jakea712/nixieClock_ZM1000/nixieClock_ZM1000.kicad_pcb

## KiCad design nixieClock_ZM1000.kicad_pcb (2020-04-06)

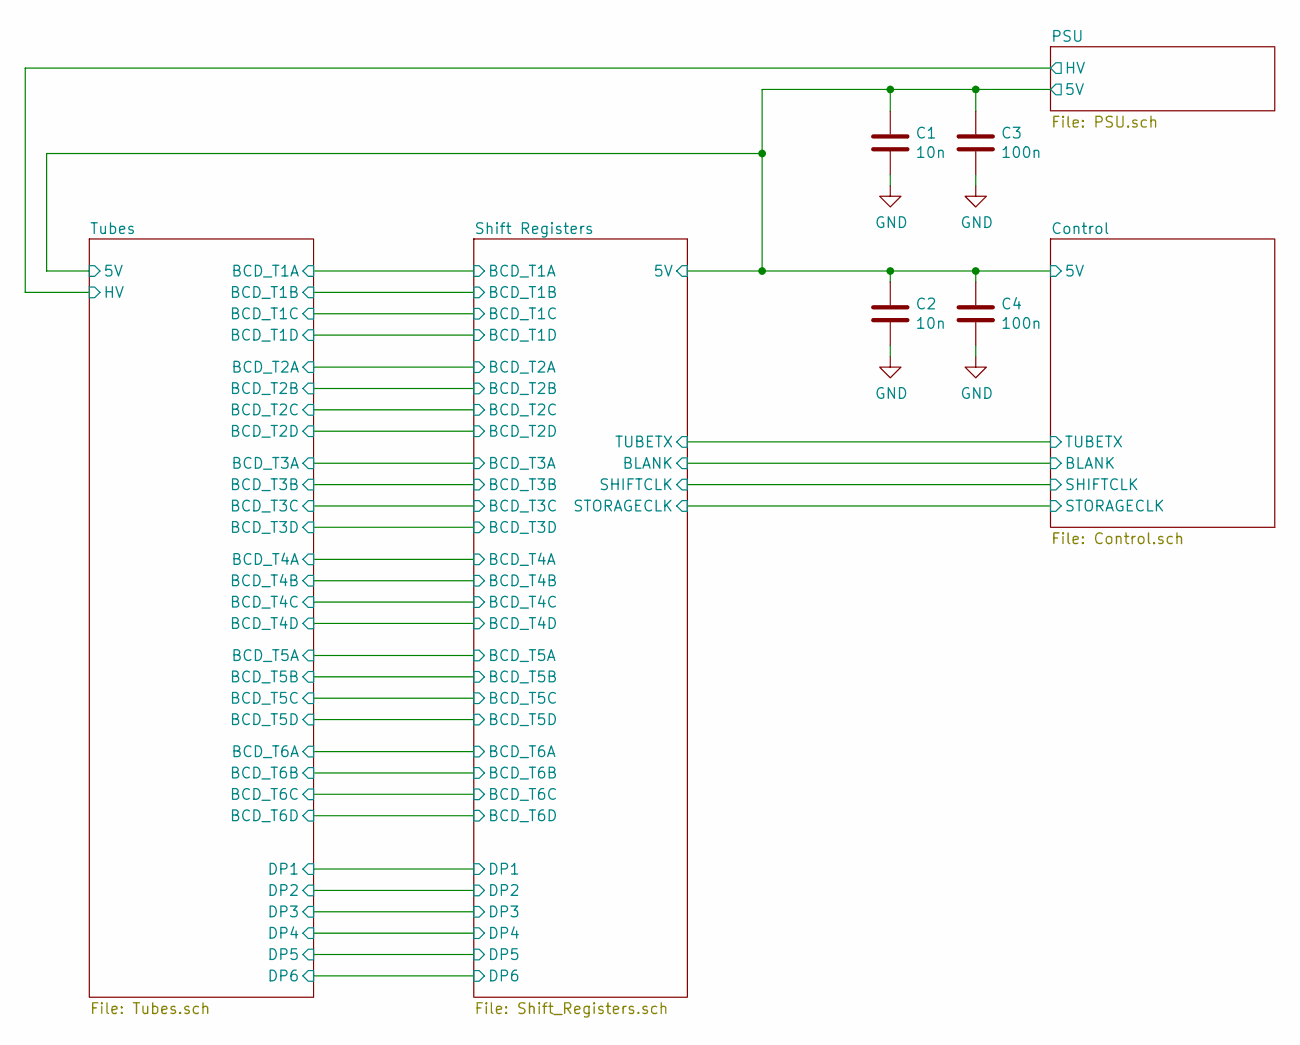
[picture p1: schematic nixieClock_ZM1000.sch]

Parts:
C1, C2: 10n; C_Disc_D3.8mm_W2.6mm_P2.50mm
C3, C4: 100n; C_Disc_D5.0mm_W2.5mm_P2.50mm

Connections:
/Control/5V: C1.1, C2.1, C3.1, C4.1; also elsewhere on the board
GND: C1.2, C2.2, C3.2, C4.2; also elsewhere on the board

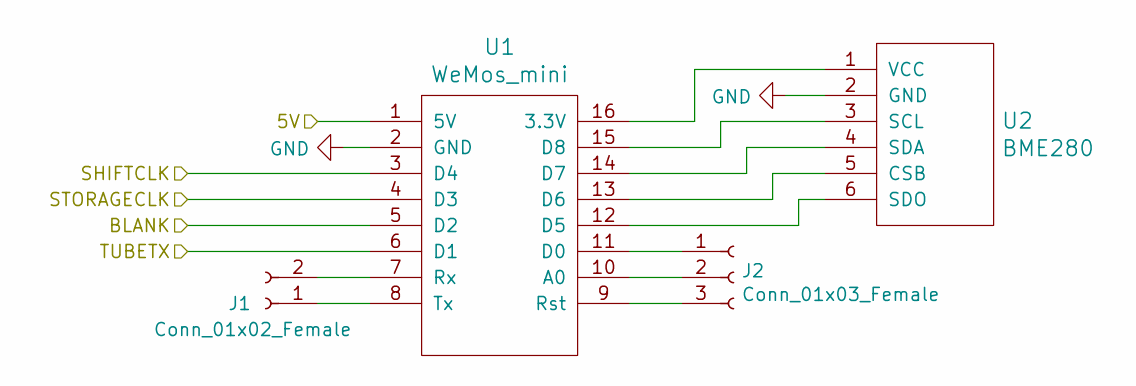
[picture p2: schematic Control.sch]

Parts:
J1: Conn_01x02_Female; PinHeader_1x02_P2.54mm_Vertical
J2: Conn_01x03_Female; PinHeader_1x03_P2.54mm_Vertical
U1: WeMos_mini; D1_mini_board
U2: BME280

Connections:
/Control/5V: U1.1 (5V); also elsewhere on the board
/Control/BLANK: U1.5 (D2); also elsewhere on the board
/Control/SHIFTCLK: U1.3 (D4); also elsewhere on the board
/Control/STORAGECLK: U1.4 (D3); also elsewhere on the board
/Control/TUBETX: U1.6 (D1); also elsewhere on the board
GND: U1.2 (GND), U2.2 (GND); also elsewhere on the board
unnamed: J1.1, U1.8 (Tx)
unnamed: J1.2, U1.7 (Rx)
unnamed: J2.1, U1.11 (D0)
unnamed: J2.2, U1.10 (A0)
unnamed: J2.3, U1.9 (Rst)
unnamed: U1.12 (D5), U2.6 (SDO)
unnamed: U1.13 (D6), U2.5 (CSB)
unnamed: U1.14 (D7), U2.4 (SDA)
unnamed: U1.15 (D8), U2.3 (SCL)
unnamed: U1.16 (3.3V), U2.1 (VCC)

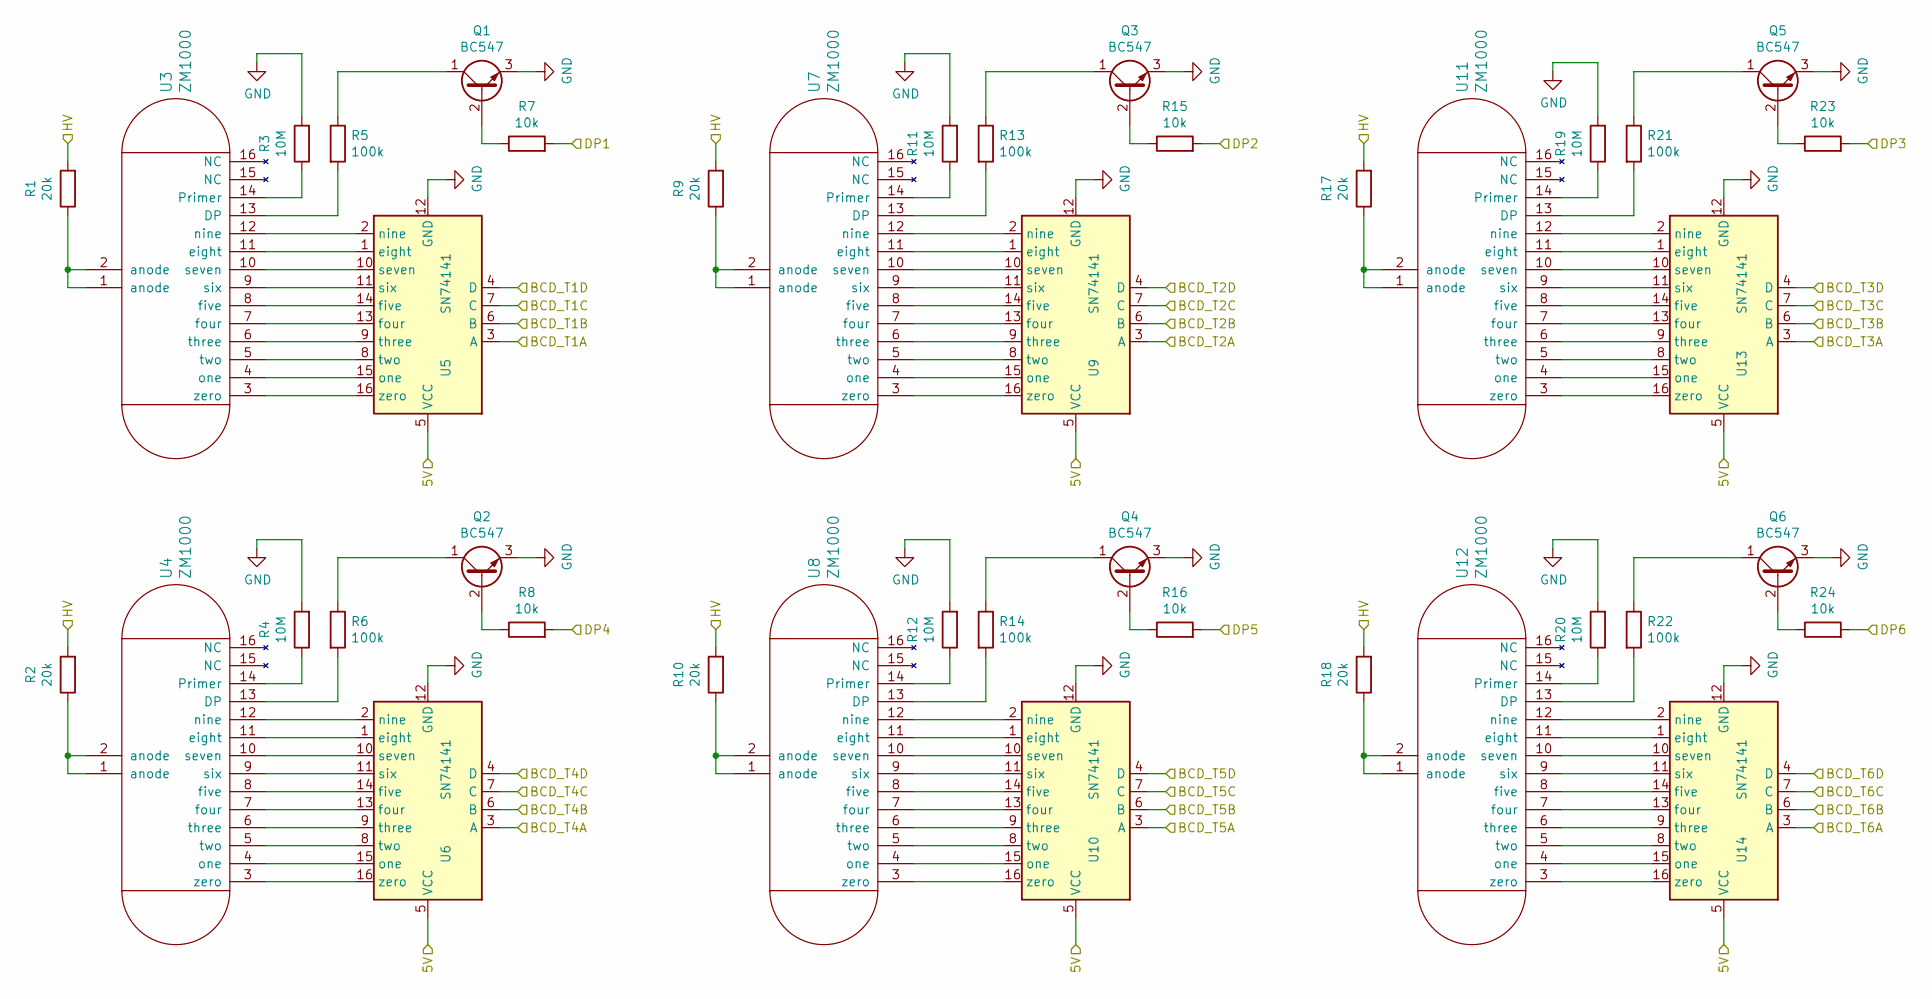
[picture p3: schematic Tubes.sch]

Parts:
Q1, Q2, Q3, Q4, Q5, Q6: BC547; TO-92_Inline
R1, R2, R9, R10, R17, R18: 20k; R_Axial_DIN0207_L6.3mm_D2.5mm_P10.16mm_Horizontal
R3, R4, R11, R12, R19, R20: 10M; R_Axial_DIN0207_L6.3mm_D2.5mm_P10.16mm_Horizontal
R5, R6, R13, R14, R21, R22: 100k; R_Axial_DIN0207_L6.3mm_D2.5mm_P10.16mm_Horizontal
R7, R8, R15, R16, R23, R24: 10k; R_Axial_DIN0207_L6.3mm_D2.5mm_P10.16mm_Horizontal
U3, U4, U7, U8, U11, U12: ZM1000; Nixie_ZM1000
U5, U6, U9, U10, U13, U14: SN74141; DIP-16_W7.62mm

Connections:
/Control/5V: U5.5 (VCC), U6.5 (VCC), U9.5 (VCC), U10.5 (VCC), U13.5 (VCC), U14.5 (VCC); also elsewhere on the board
/PSU/HV: R1.2, R2.2, R9.2, R10.2, R17.2, R18.2; also elsewhere on the board
/Shift Registers/BCD_T1A: U5.3 (A); also elsewhere on the board
/Shift Registers/BCD_T1B: U5.6 (B); also elsewhere on the board
/Shift Registers/BCD_T1C: U5.7 (C); also elsewhere on the board
/Shift Registers/BCD_T1D: U5.4 (D); also elsewhere on the board
/Shift Registers/BCD_T2A: U9.3 (A); also elsewhere on the board
/Shift Registers/BCD_T2B: U9.6 (B); also elsewhere on the board
/Shift Registers/BCD_T2C: U9.7 (C); also elsewhere on the board
/Shift Registers/BCD_T2D: U9.4 (D); also elsewhere on the board
/Shift Registers/BCD_T3A: U13.3 (A); also elsewhere on the board
/Shift Registers/BCD_T3B: U13.6 (B); also elsewhere on the board
/Shift Registers/BCD_T3C: U13.7 (C); also elsewhere on the board
/Shift Registers/BCD_T3D: U13.4 (D); also elsewhere on the board
/Shift Registers/BCD_T4A: U6.3 (A); also elsewhere on the board
/Shift Registers/BCD_T4B: U6.6 (B); also elsewhere on the board
/Shift Registers/BCD_T4C: U6.7 (C); also elsewhere on the board
/Shift Registers/BCD_T4D: U6.4 (D); also elsewhere on the board
/Shift Registers/BCD_T5A: U10.3 (A); also elsewhere on the board
/Shift Registers/BCD_T5B: U10.6 (B); also elsewhere on the board
/Shift Registers/BCD_T5C: U10.7 (C); also elsewhere on the board
/Shift Registers/BCD_T5D: U10.4 (D); also elsewhere on the board
/Shift Registers/BCD_T6A: U14.3 (A); also elsewhere on the board
/Shift Registers/BCD_T6B: U14.6 (B); also elsewhere on the board
/Shift Registers/BCD_T6C: U14.7 (C); also elsewhere on the board
/Shift Registers/BCD_T6D: U14.4 (D); also elsewhere on the board
/Shift Registers/DP1: R7.2; also elsewhere on the board
/Shift Registers/DP2: R15.2; also elsewhere on the board
/Shift Registers/DP3: R23.2; also elsewhere on the board
/Shift Registers/DP4: R8.2; also elsewhere on the board
/Shift Registers/DP5: R16.2; also elsewhere on the board
/Shift Registers/DP6: R24.2; also elsewhere on the board
GND: Q1.3 (E), Q2.3 (E), Q3.3 (E), Q4.3 (E), Q5.3 (E), Q6.3 (E), R3.2, R4.2, R11.2, R12.2, R19.2, R20.2, U5.12 (GND), U6.12 (GND), U9.12 (GND), U10.12 (GND), U13.12 (GND), U14.12 (GND); also elsewhere on the board
unnamed: Q1.1 (C), R5.1
unnamed: Q1.2 (B), R7.1
unnamed: Q2.1 (C), R6.1
unnamed: Q2.2 (B), R8.1
unnamed: Q3.1 (C), R13.1
unnamed: Q3.2 (B), R15.1
unnamed: Q4.1 (C), R14.1
unnamed: Q4.2 (B), R16.1
unnamed: Q5.1 (C), R21.1
unnamed: Q5.2 (B), R23.1
unnamed: Q6.1 (C), R22.1
unnamed: Q6.2 (B), R24.1
unnamed: R1.1, U3.1 (anode), U3.2 (anode)
unnamed: R2.1, U4.1 (anode), U4.2 (anode)
unnamed: R3.1, U3.14 (Primer)
unnamed: R4.1, U4.14 (Primer)
unnamed: R5.2, U3.13 (DP)
unnamed: R6.2, U4.13 (DP)
unnamed: R9.1, U7.1 (anode), U7.2 (anode)
unnamed: R10.1, U8.1 (anode), U8.2 (anode)
unnamed: R11.1, U7.14 (Primer)
unnamed: R12.1, U8.14 (Primer)
unnamed: R13.2, U7.13 (DP)
unnamed: R14.2, U8.13 (DP)
unnamed: R17.1, U11.1 (anode), U11.2 (anode)
unnamed: R18.1, U12.1 (anode), U12.2 (anode)
unnamed: R19.1, U11.14 (Primer)
unnamed: R20.1, U12.14 (Primer)
unnamed: R21.2, U11.13 (DP)
unnamed: R22.2, U12.13 (DP)
unnamed: U3.3 (zero), U5.16 (zero)
unnamed: U3.4 (one), U5.15 (one)
unnamed: U3.5 (two), U5.8 (two)
unnamed: U3.6 (three), U5.9 (three)
unnamed: U3.7 (four), U5.13 (four)
unnamed: U3.8 (five), U5.14 (five)
unnamed: U3.9 (six), U5.11 (six)
unnamed: U3.10 (seven), U5.10 (seven)
unnamed: U3.11 (eight), U5.1 (eight)
unnamed: U3.12 (nine), U5.2 (nine)
unnamed: U4.3 (zero), U6.16 (zero)
unnamed: U4.4 (one), U6.15 (one)
unnamed: U4.5 (two), U6.8 (two)
unnamed: U4.6 (three), U6.9 (three)
unnamed: U4.7 (four), U6.13 (four)
unnamed: U4.8 (five), U6.14 (five)
unnamed: U4.9 (six), U6.11 (six)
unnamed: U4.10 (seven), U6.10 (seven)
unnamed: U4.11 (eight), U6.1 (eight)
unnamed: U4.12 (nine), U6.2 (nine)
unnamed: U7.3 (zero), U9.16 (zero)
unnamed: U7.4 (one), U9.15 (one)
unnamed: U7.5 (two), U9.8 (two)
unnamed: U7.6 (three), U9.9 (three)
unnamed: U7.7 (four), U9.13 (four)
unnamed: U7.8 (five), U9.14 (five)
unnamed: U7.9 (six), U9.11 (six)
unnamed: U7.10 (seven), U9.10 (seven)
unnamed: U7.11 (eight), U9.1 (eight)
unnamed: U7.12 (nine), U9.2 (nine)
unnamed: U8.11 (eight), U10.1 (eight)
unnamed: U8.12 (nine), U10.2 (nine)
unnamed: U8.5 (two), U10.8 (two)
unnamed: U8.6 (three), U10.9 (three)
unnamed: U8.10 (seven), U10.10 (seven)
unnamed: U8.9 (six), U10.11 (six)
unnamed: U8.7 (four), U10.13 (four)
unnamed: U8.8 (five), U10.14 (five)
unnamed: U8.4 (one), U10.15 (one)
unnamed: U8.3 (zero), U10.16 (zero)
unnamed: U11.3 (zero), U13.16 (zero)
unnamed: U11.4 (one), U13.15 (one)
unnamed: U11.5 (two), U13.8 (two)
unnamed: U11.6 (three), U13.9 (three)
unnamed: U11.7 (four), U13.13 (four)
unnamed: U11.8 (five), U13.14 (five)
unnamed: U11.9 (six), U13.11 (six)
unnamed: U11.10 (seven), U13.10 (seven)
unnamed: U11.11 (eight), U13.1 (eight)
unnamed: U11.12 (nine), U13.2 (nine)
unnamed: U12.3 (zero), U14.16 (zero)
unnamed: U12.4 (one), U14.15 (one)
unnamed: U12.5 (two), U14.8 (two)
unnamed: U12.6 (three), U14.9 (three)
unnamed: U12.7 (four), U14.13 (four)
unnamed: U12.8 (five), U14.14 (five)
unnamed: U12.9 (six), U14.11 (six)
unnamed: U12.10 (seven), U14.10 (seven)
unnamed: U12.11 (eight), U14.1 (eight)
unnamed: U12.12 (nine), U14.2 (nine)

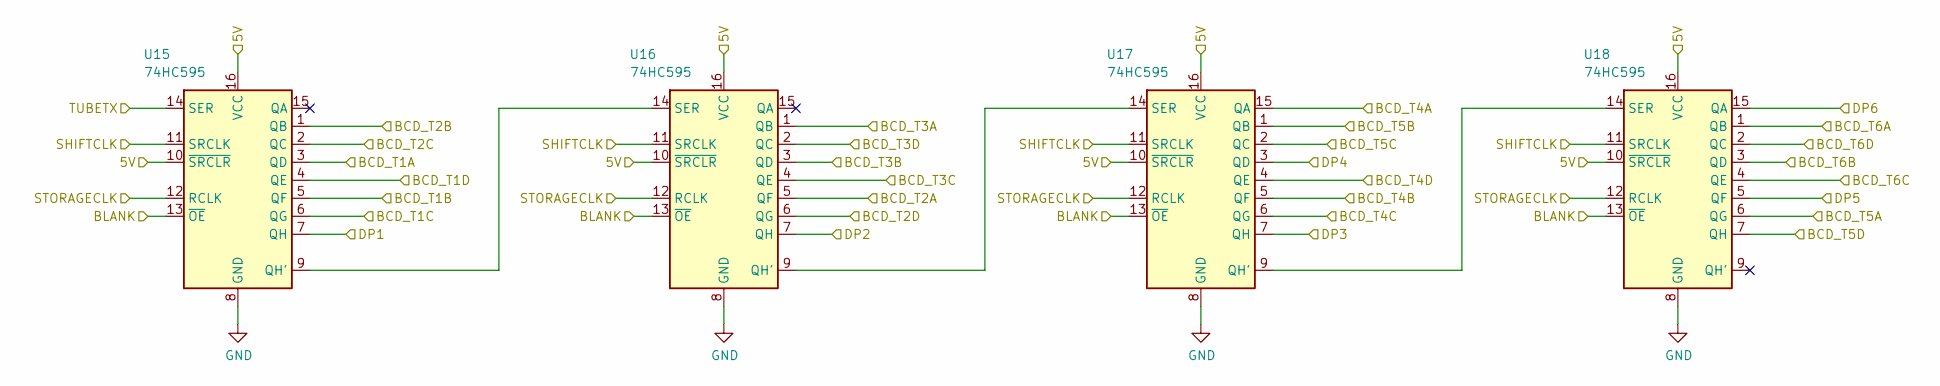
[picture p4: schematic Shift_Registers.sch]

Parts:
U15, U16, U17, U18: 74HC595; DIP-16_W7.62mm

Connections:
/Control/5V: U15.10 (~SRCLR), U15.16 (VCC), U16.10 (~SRCLR), U16.16 (VCC), U17.10 (~SRCLR), U17.16 (VCC), U18.10 (~SRCLR), U18.16 (VCC); also elsewhere on the board
/Control/BLANK: U15.13 (~OE), U16.13 (~OE), U17.13 (~OE), U18.13 (~OE); also elsewhere on the board
/Control/SHIFTCLK: U15.11 (SRCLK), U16.11 (SRCLK), U17.11 (SRCLK), U18.11 (SRCLK); also elsewhere on the board
/Control/STORAGECLK: U15.12 (RCLK), U16.12 (RCLK), U17.12 (RCLK), U18.12 (RCLK); also elsewhere on the board
/Control/TUBETX: U15.14 (SER); also elsewhere on the board
/Shift Registers/BCD_T1A: U15.3 (QD); also elsewhere on the board
/Shift Registers/BCD_T1B: U15.5 (QF); also elsewhere on the board
/Shift Registers/BCD_T1C: U15.6 (QG); also elsewhere on the board
/Shift Registers/BCD_T1D: U15.4 (QE); also elsewhere on the board
/Shift Registers/BCD_T2A: U16.5 (QF); also elsewhere on the board
/Shift Registers/BCD_T2B: U15.1 (QB); also elsewhere on the board
/Shift Registers/BCD_T2C: U15.2 (QC); also elsewhere on the board
/Shift Registers/BCD_T2D: U16.6 (QG); also elsewhere on the board
/Shift Registers/BCD_T3A: U16.1 (QB); also elsewhere on the board
/Shift Registers/BCD_T3B: U16.3 (QD); also elsewhere on the board
/Shift Registers/BCD_T3C: U16.4 (QE); also elsewhere on the board
/Shift Registers/BCD_T3D: U16.2 (QC); also elsewhere on the board
/Shift Registers/BCD_T4A: U17.15 (QA); also elsewhere on the board
/Shift Registers/BCD_T4B: U17.5 (QF); also elsewhere on the board
/Shift Registers/BCD_T4C: U17.6 (QG); also elsewhere on the board
/Shift Registers/BCD_T4D: U17.4 (QE); also elsewhere on the board
/Shift Registers/BCD_T5A: U18.6 (QG); also elsewhere on the board
/Shift Registers/BCD_T5B: U17.1 (QB); also elsewhere on the board
/Shift Registers/BCD_T5C: U17.2 (QC); also elsewhere on the board
/Shift Registers/BCD_T5D: U18.7 (QH); also elsewhere on the board
/Shift Registers/BCD_T6A: U18.1 (QB); also elsewhere on the board
/Shift Registers/BCD_T6B: U18.3 (QD); also elsewhere on the board
/Shift Registers/BCD_T6C: U18.4 (QE); also elsewhere on the board
/Shift Registers/BCD_T6D: U18.2 (QC); also elsewhere on the board
/Shift Registers/DP1: U15.7 (QH); also elsewhere on the board
/Shift Registers/DP2: U16.7 (QH); also elsewhere on the board
/Shift Registers/DP3: U17.7 (QH); also elsewhere on the board
/Shift Registers/DP4: U17.3 (QD); also elsewhere on the board
/Shift Registers/DP5: U18.5 (QF); also elsewhere on the board
/Shift Registers/DP6: U18.15 (QA); also elsewhere on the board
GND: U15.8 (GND), U16.8 (GND), U17.8 (GND), U18.8 (GND); also elsewhere on the board
unnamed: U15.9 (QH'), U16.14 (SER)
unnamed: U16.9 (QH'), U17.14 (SER)
unnamed: U17.9 (QH'), U18.14 (SER)

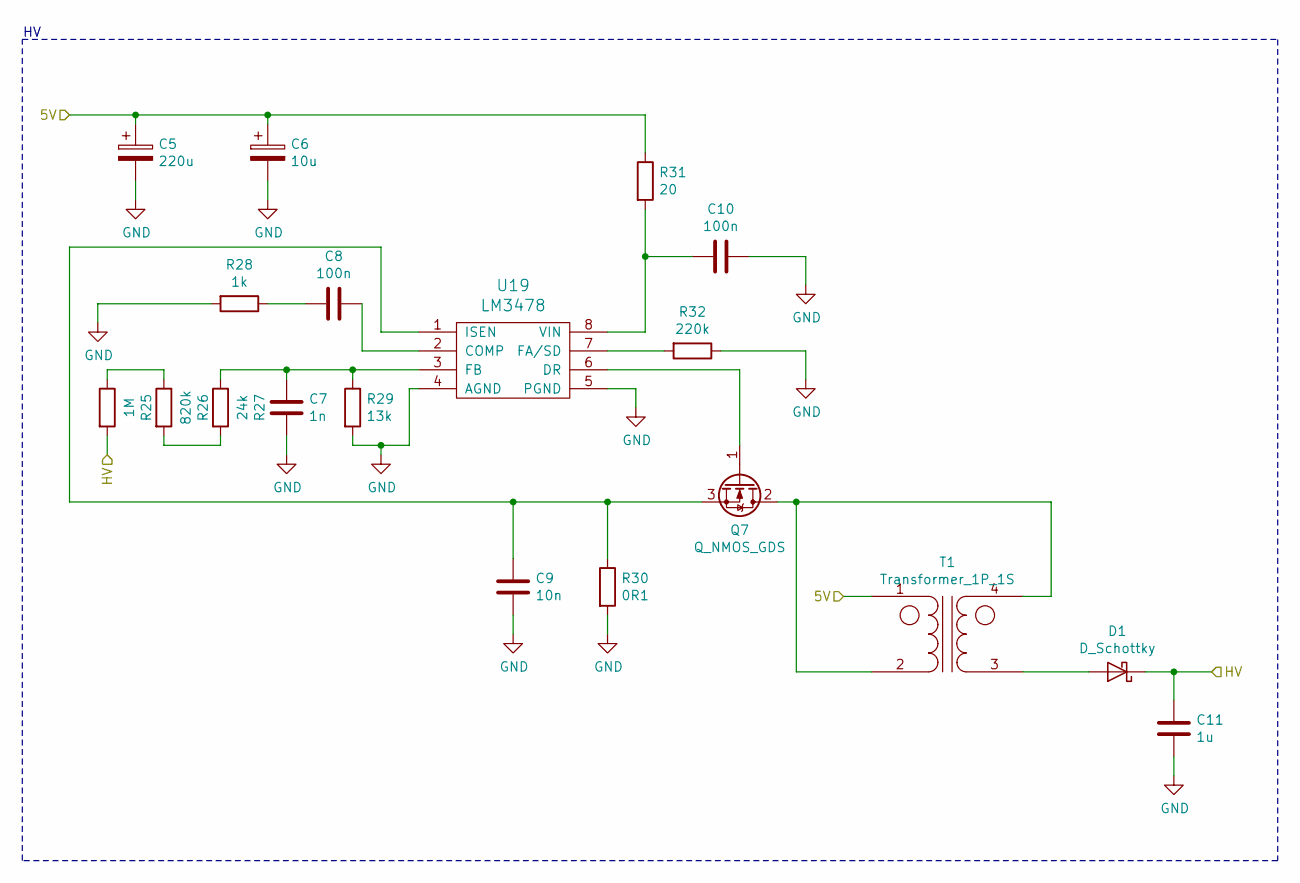
[picture p5: schematic PSU.sch]

Parts:
C5: 220u; CP_Radial_D5.0mm_P2.00mm
C6: 10u; CP_Radial_D4.0mm_P1.50mm
C7: 1n; C_Disc_D3.8mm_W2.6mm_P2.50mm
C8: 100n; C_Disc_D3.8mm_W2.6mm_P2.50mm
C9: 10n; C_Disc_D3.8mm_W2.6mm_P2.50mm
C10: 100n; C_Disc_D5.0mm_W2.5mm_P2.50mm
C11: 1u; CP_Radial_D6.3mm_P2.50mm
D1: D_Schottky; D_DO-41_SOD81_P10.16mm_Horizontal
Q7: Q_NMOS_GDS; TO-220-3_Horizontal_TabDown
R25: 1M; R_Axial_DIN0207_L6.3mm_D2.5mm_P10.16mm_Horizontal
R26: 820k; R_Axial_DIN0207_L6.3mm_D2.5mm_P10.16mm_Horizontal
R27: 24k; R_Axial_DIN0207_L6.3mm_D2.5mm_P10.16mm_Horizontal
R28: 1k; R_Axial_DIN0207_L6.3mm_D2.5mm_P10.16mm_Horizontal
R29: 13k; R_Axial_DIN0207_L6.3mm_D2.5mm_P10.16mm_Horizontal
R30: 0R1; R_Axial_DIN0207_L6.3mm_D2.5mm_P10.16mm_Horizontal
R31: 20; R_Axial_DIN0207_L6.3mm_D2.5mm_P10.16mm_Horizontal
R32: 220k; R_Axial_DIN0207_L6.3mm_D2.5mm_P10.16mm_Horizontal
T1: Transformer_1P_1S; Transformer_LPR6235
U19: LM3478; VSSOP-8_3.0x3.0mm_P0.65mm

Connections:
/Control/5V: C5.1, C6.1, R31.1, T1.1 (AA); also elsewhere on the board
/PSU/HV: C11.1, D1.1 (K), R25.2; also elsewhere on the board
GND: C5.2, C6.2, C7.2, C9.2, C10.1, C11.2, R28.2, R29.2, R30.2, R32.1, U19.4 (AGND), U19.5 (PGND); also elsewhere on the board
unnamed: C7.1, R27.1, R29.1, U19.3 (FB)
unnamed: C8.1, U19.2 (COMP)
unnamed: C8.2, R28.1
unnamed: C9.1, Q7.3 (S), R30.1, U19.1 (ISEN)
unnamed: C10.2, R31.2, U19.8 (VIN)
unnamed: D1.2 (A), T1.3 (SA)
unnamed: Q7.1 (G), U19.6 (DR)
unnamed: Q7.2 (D), T1.2 (AB), T1.4 (SB)
unnamed: R25.1, R26.1
unnamed: R26.2, R27.2
unnamed: R32.2, U19.7 (FA/SD)

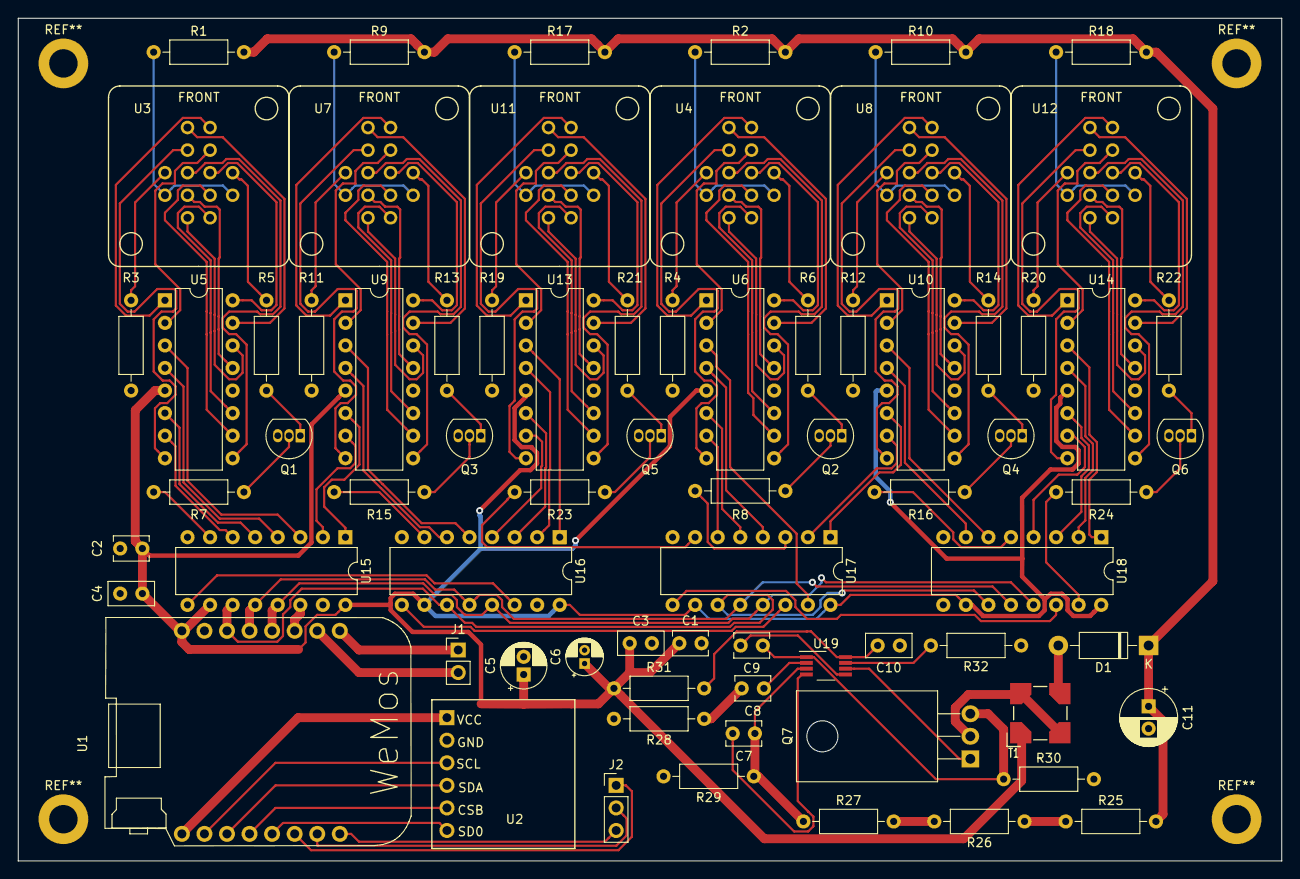
[picture p6: board nixieClock_ZM1000.kicad_pcb from above]

Board: 2 copper layers, 142.2 x 94.9 mm, 73 parts (0 on the bottom side), 151 nets.
