jakea712/nixieClock_ZM1000/(commit log)

2019-09-23 Inserted PSU
    [nixieClock_ZM1000.sch]
2019-09-23 Added sheets
    [Control.sch, PSUsch.sch]
2019-09-30 Finished draft schema
    [Control.sch, PSU.sch, Shift_Registers.sch, Tubes.sch, nixieClock_ZM1000.sch]
2019-10-03 Moved DPs to shift register as not enough IO
    [nixieClock_ZM1000.sch]
2019-10-03 Finished schema and started PCB layout
    [Control.sch, PSU.sch, Shift_Registers.sch, Tubes.sch, nixieClock_ZM1000.kicad_pcb]
2019-10-04 90% routed
    [Control.sch, PSU.sch, Shift_Registers.sch, nixieClock_ZM1000.kicad_pcb]
2019-10-05 Completed layout inc optimisation of data pattern for shift registers
    [Control.sch, Shift_Registers.sch, nixieClock_ZM1000.kicad_pcb, nixieClock_ZM1000.sch]
2019-10-05 Added more decoupling
    [nixieClock_ZM1000.kicad_pcb, nixieClock_ZM1000.sch]
2019-10-08 Update to PSU
    [PSU.sch, nixieClock_ZM1000.kicad_pcb]
2019-10-09 Corrected errors on PSU
    [PSU.sch, nixieClock_ZM1000.kicad_pcb]
2019-10-14 Szitched to DIP shift registers, added BME280
    [Control.sch, Shift_Registers.sch, Tubes.sch, nixieClock_ZM1000.kicad_pcb]
2019-10-18 Final pending check
    [Control.sch, PSU.sch, Tubes.sch, nixieClock_ZM1000.kicad_pcb]
2020-04-06 Fixed tube footprints and rerouted
    [Control.sch, PSU.sch, Shift_Registers.sch, Tubes.sch, nixieClock_ZM1000.kicad_pcb, nixieClock_ZM1000.sch]
